svcisr/lora-door-sensor/docs/board-photos/dx-pj26-back.webp

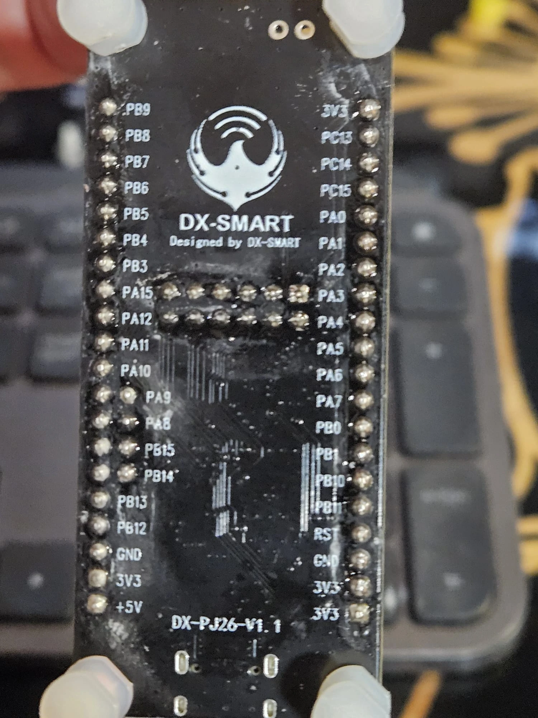
docs/board-photos/dx-pj26-back.webp
