svcisr/lora-door-sensor/docs/board-photos/dx-pj26-front.webp

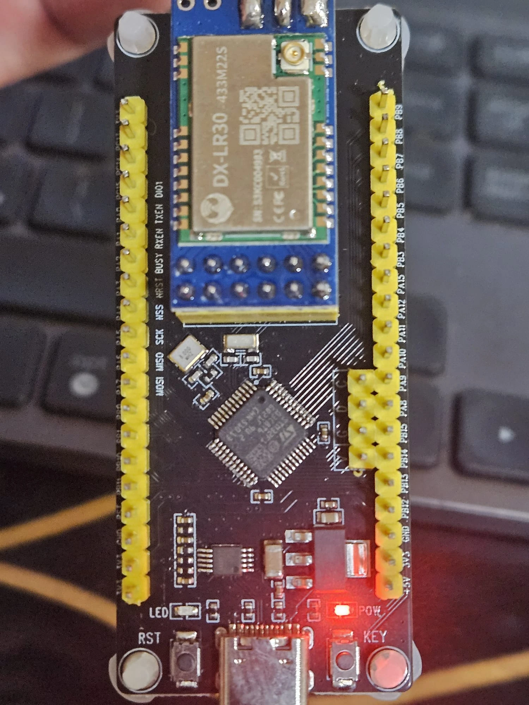
docs/board-photos/dx-pj26-front.webp
