svcisr/lora-door-sensor/enclosure/preview_base.png

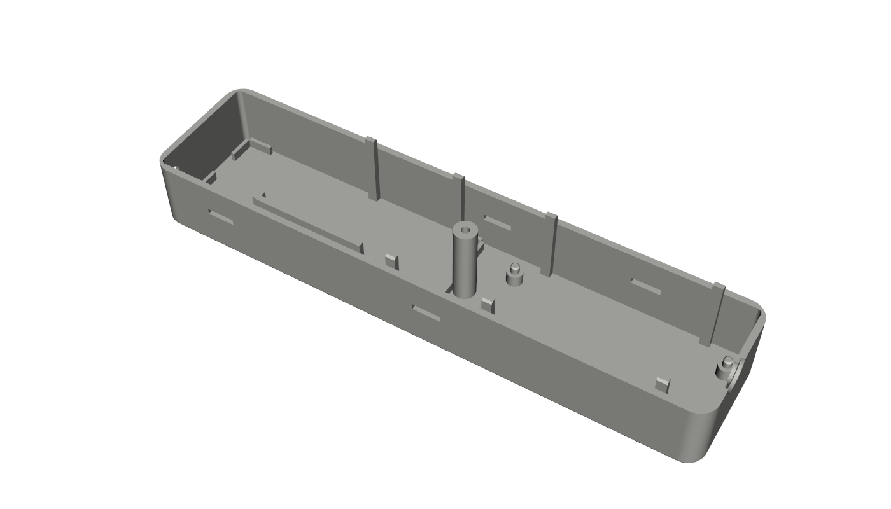
enclosure/preview_base.png
