svcisr/lora-door-sensor/enclosure/preview_exploded.png

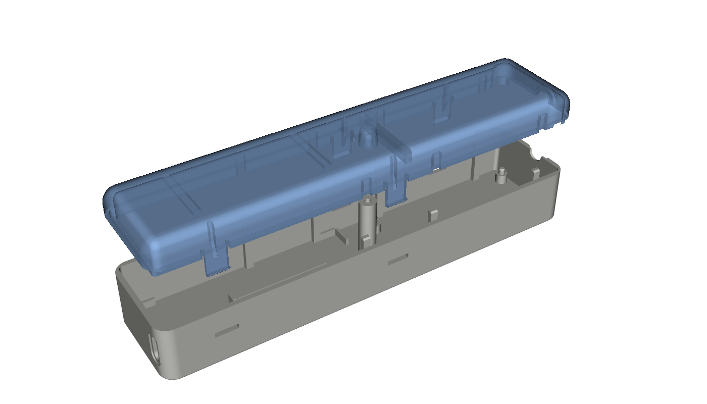
enclosure/preview_exploded.png
