svcisr/lora-door-sensor/enclosure/preview_lid_underside.png

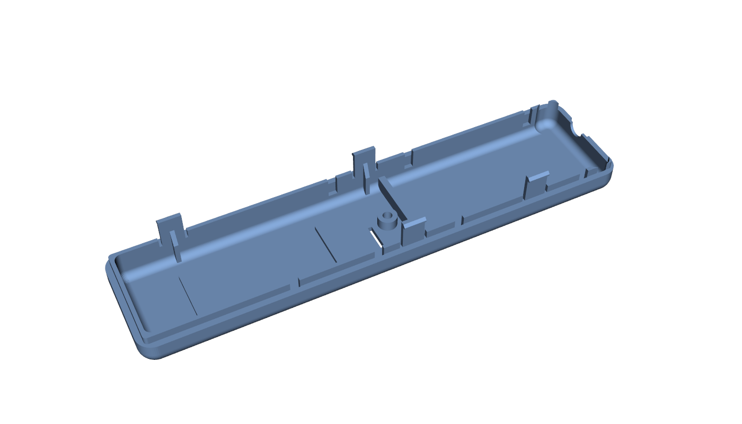
enclosure/preview_lid_underside.png
