svcisr/lora-door-sensor/enclosure/receiver_hole_check.png

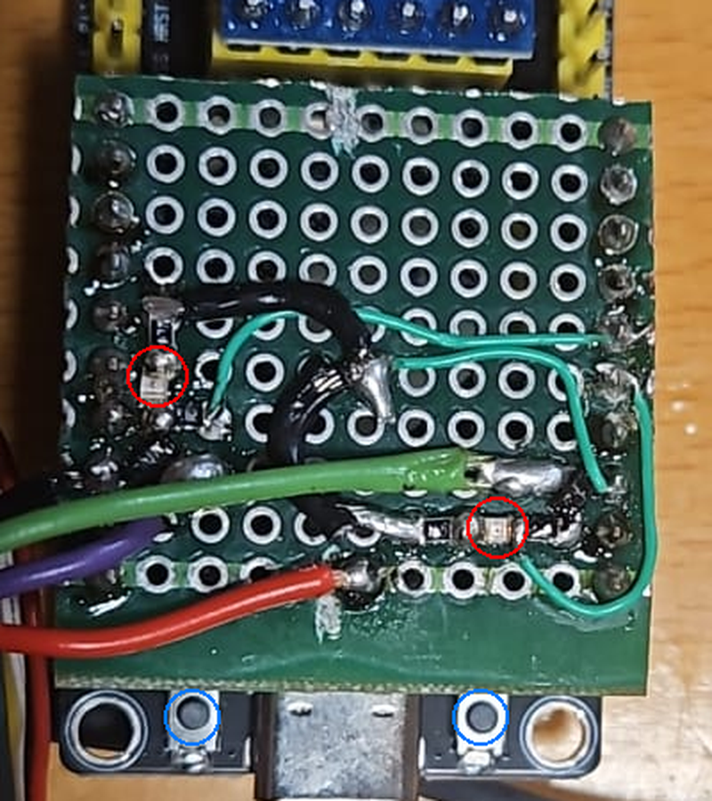
enclosure/receiver_hole_check.png
