svcisr/lora-door-sensor/enclosure/receiver_preview_closed.png

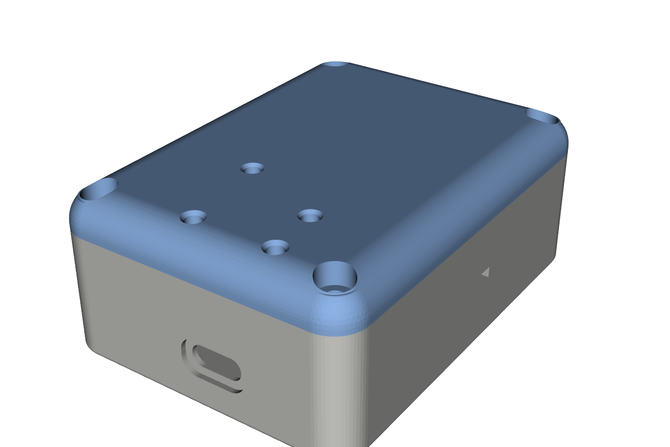
enclosure/receiver_preview_closed.png
