svcisr/lora-door-sensor/enclosure/receiver_preview_lid_top.png

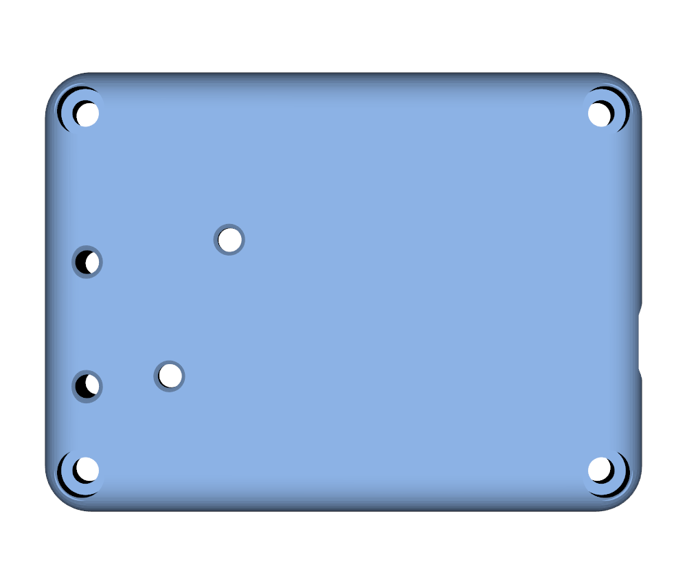
enclosure/receiver_preview_lid_top.png
