svcisr/lora-door-sensor/enclosure/receiver_preview_lid_underside.png

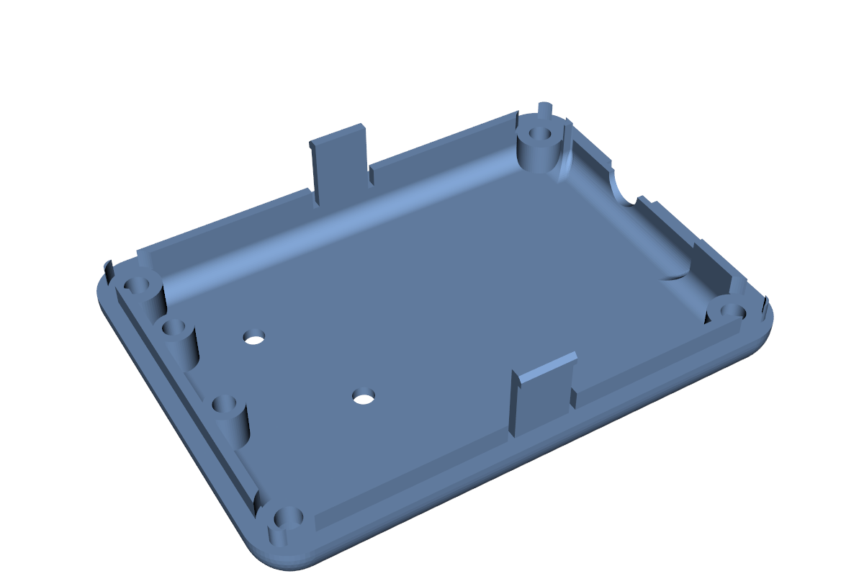
enclosure/receiver_preview_lid_underside.png
