svcisr/lora-door-sensor/enclosure/receiver_preview_top.png

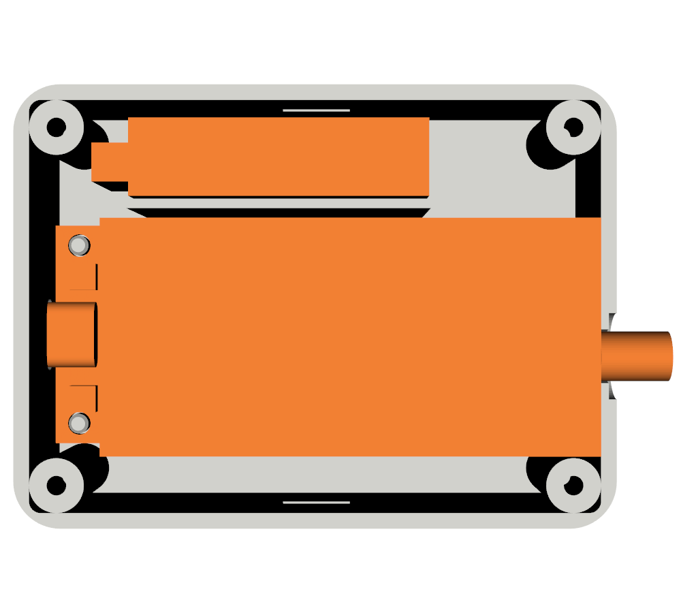
enclosure/receiver_preview_top.png
