svcisr/lora-door-sensor/enclosure/door_sensor_box_assembly.step

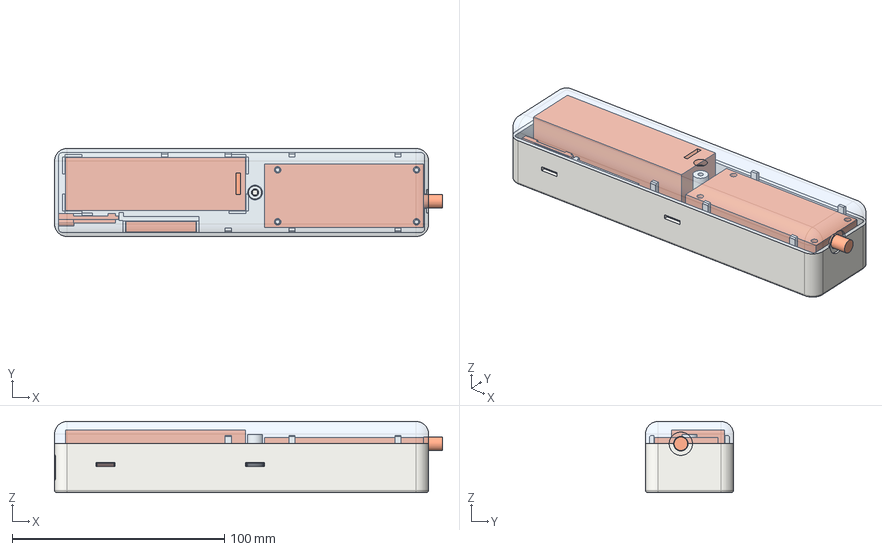
[picture p17: CAD file, 2026-11-05]
enclosure/door_sensor_box_assembly.step
183.0 x 41.6 x 33.5 mm
base
lid
ref_charger
ref_battery_holder
ref_board_stack
ref_sma
ref_reed_board
