svcisr/lora-door-sensor/enclosure/receiver_box_assembly.step

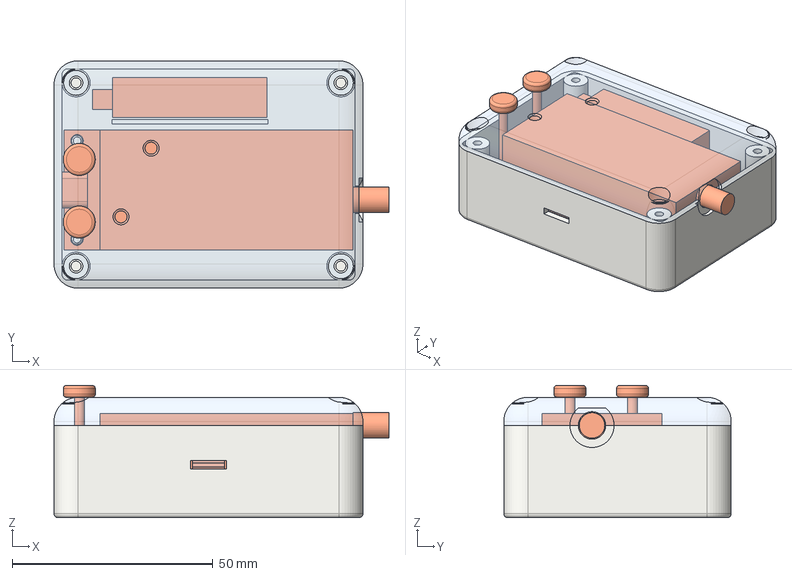
[picture p18: CAD file, 2026-11-05]
enclosure/receiver_box_assembly.step
83.5 x 56.7 x 33.0 mm
base
lid
ref_pcb
ref_stack
ref_usb
ref_KEY
ref_RST
ref_sma
ref_shelly
ref_stick_KEY
ref_stick_RST
