svcisr/lora-door-sensor/enclosure/door_sensor_box_lid.step

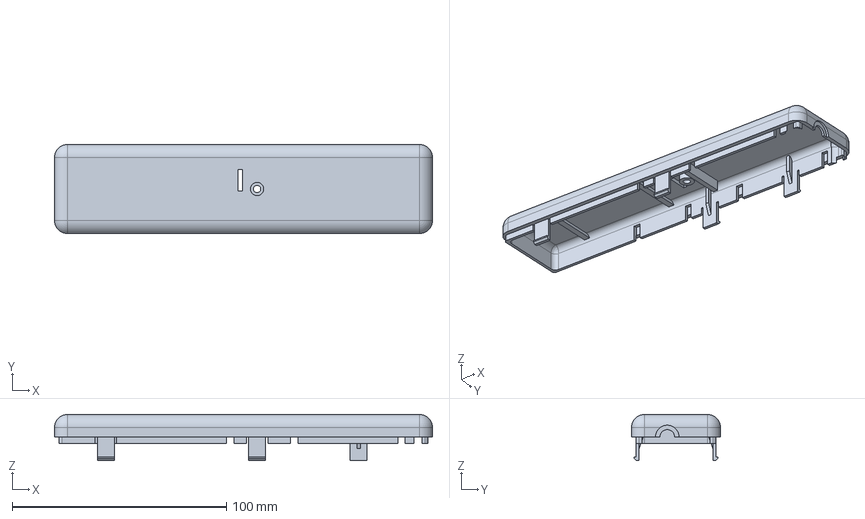
[picture p19: CAD file, 2026-11-05]
enclosure/door_sensor_box_lid.step
176.5 x 41.6 x 21.5 mm
