svcisr/lora-door-sensor/enclosure/door_sensor_box_base.step

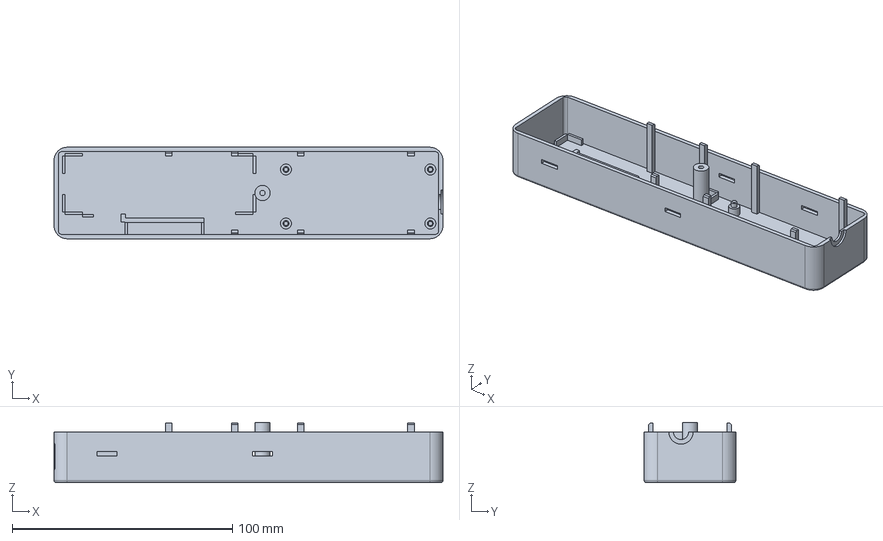
[picture p20: CAD file, 2026-11-05]
enclosure/door_sensor_box_base.step
176.5 x 41.6 x 27.4 mm
