svcisr/lora-door-sensor/enclosure/receiver_box_base.step

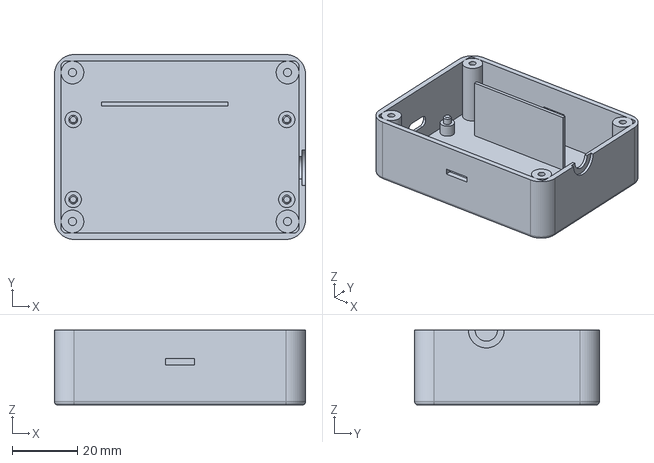
[picture p21: CAD file, 2026-11-05]
enclosure/receiver_box_base.step
77.0 x 56.7 x 23.0 mm
