svcisr/lora-door-sensor/enclosure/receiver_box_lid.step

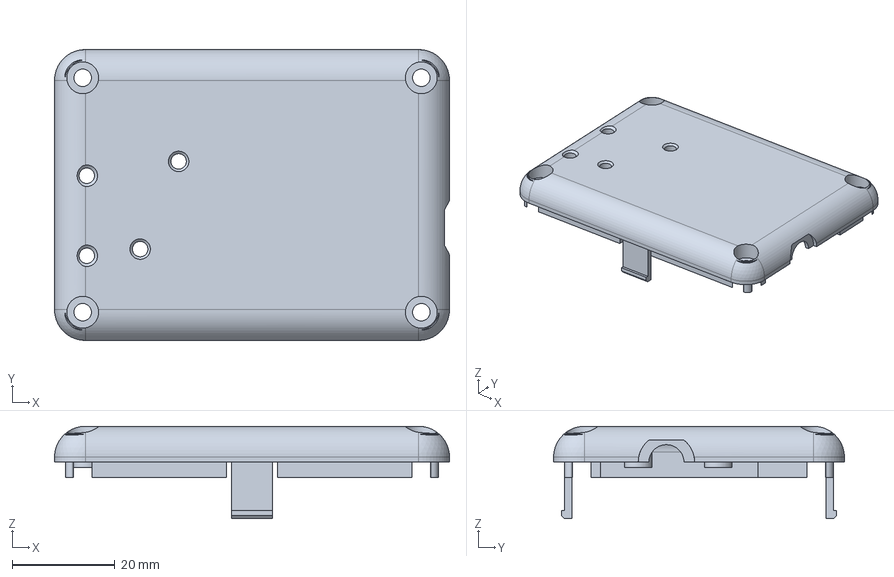
[picture p22: CAD file, 2026-11-05]
enclosure/receiver_box_lid.step
77.0 x 56.7 x 18.0 mm
