svcisr/lora-door-sensor/enclosure/receiver_box_stick.step

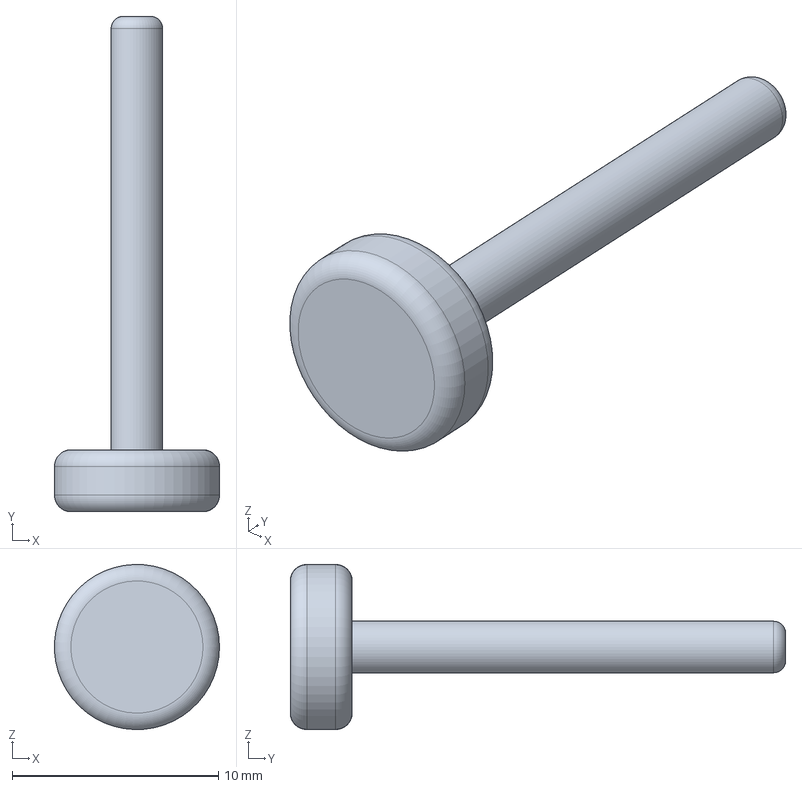
[picture p23: CAD file, 2026-11-05]
enclosure/receiver_box_stick.step
7.99 x 24.0 x 8.00 mm
