svcisr/lora-door-sensor/(list of files, cad)

Other CAD files:
enclosure/door_sensor_box_base.stl
enclosure/door_sensor_box_lid.stl
enclosure/receiver_box_base.stl
enclosure/receiver_box_lid.stl
enclosure/receiver_box_stick.stl
