svcisr/lora-door-sensor/(commit log)

2026-11-02 LoRa door sensor: firmware, tools and 3D-printable enclosure
    Battery door sensor and receiver for DX-SMART DX-LR30-433M22SP boards
    (STM32F103C8 + SX1262, 433 MHz): sensor and receiver firmware, a USB
    flasher for the STM32 ROM bootloader, serial log and LoRa option tools,
    engineering notes, and a snap-fit resin enclosure (CadQuery, STEP, STL).
    Network IDs are examples; pick your own.
    [door_sensor_box_assembly.step, door_sensor_box_base.step, door_sensor_box_base.stl, door_sensor_box_lid.step, door_sensor_box_lid.stl]
2026-11-02 Add receiver enclosure (board + Shelly UNI) with push stick
    A second snap-fit box for the receiver: the DX-PJ26 stack and a Shelly
    UNI standing on edge beside it, separated by a partition. Rounded lid
    with one snap tab per long side and four M3 corner screws, 3 mm holes
    with short guide cylinders over KEY/RST plus a push stick, and 3 mm
    holes over the two perfboard LEDs. USB-C and SMA through the end walls.
    Also: the SMA is 12.5 mm from the PB header edge in both boxes.
    [receiver_box_assembly.step, receiver_box_base.step, receiver_box_base.stl, receiver_box_lid.step, receiver_box_lid.stl, receiver_box_stick.step, receiver_box_stick.stl]
2026-11-03 SF12, heartbeats 5 s / 20 s / 2 min, start in 2 min mode
    - Radio runs SF12 / 125 kHz (was SF10): ~991 ms per packet, LDRO on;
    receiver logs the carrier offset (ferr=)
    - KEY modes send every 5 s / 20 s / 2 min; receiver link timeouts
    20 / 65 / 370 s (2 missed packets in a row tolerated)
    - Both boards start in the 2 min mode at every power-up; the KEY mode is
    no longer saved
    - README, notes, options page and firmware hex files updated
    [config.h, door_mode.cpp, door_mode.h, lora_options.py, main.cpp]
2026-11-05 Enclosure updates from two test prints of the sensor box
    Sensor box: reed board moved beside the charger (PB-side wall) with a
    taller, 2 mm wall behind it; charger stop plate 2 mm thick; one M3 centre
    screw between the battery and the board; lid 2.5 mm taller for the cell;
    inner wall ribs (3 x 2 mm) that rise into slots in the lid so the long
    walls can't bow out; four snap tabs with root gussets and 0.8 mm hooks;
    a 10 x 2 mm lid slot for a battery isolation tab. Both boxes: snap
    windows 0.5 mm higher.
    [door_sensor_box_assembly.step, door_sensor_box_base.step, door_sensor_box_base.stl, door_sensor_box_lid.step, door_sensor_box_lid.stl, receiver_box_assembly.step, receiver_box_base.step, receiver_box_base.stl]
